aJns/verkotetut-sulat/README.md

# verkotetut-sulat
ELT-23100 Verkotetut sulautetut järjestelmät kurssin harkkatyö
