aJns/verkotetut-sulat/selostus/tyoselostus.tex

\documentclass{article}

\usepackage{graphicx}
\usepackage{amsmath}
\usepackage[utf8]{inputenc}
\usepackage[a4paper]{geometry}
\usepackage{fullpage}
\usepackage[default]{lato}
\usepackage[ddmmyyyy]{datetime}
\usepackage[style=ieee]{biblatex}
\usepackage{url}
\usepackage[finnish]{babel}
\usepackage{hyperref}
\usepackage{float}
\usepackage{listings}
\usepackage{textcomp}

\graphicspath{{./kuvat/}}
\bibliography{tyoselostus}

%----------------------------------------------------------------------------------------
%	DOCUMENT INFORMATION
%----------------------------------------------------------------------------------------

\title{IoT Ledivilkutin \\ ELT-23100 Verkotetut sulautetut järjestelmät \\ Työselostus} % Title

\author{Jonas Nikula \\ Opnro 240497} % Author name

\date{\today} % Date for the report

\begin{document}

\maketitle % Insert the title, author and date

%----------------------------------------------------------------------------------------
%	CONTENT
%----------------------------------------------------------------------------------------

\input{sisalto}

%----------------------------------------------------------------------------------------
%	BIBLIOGRAPHY
%----------------------------------------------------------------------------------------

% \DefineBibliographyStrings{finnish}
\printbibliography{}

%----------------------------------------------------------------------------------------

\end{document}
