aJns/verkotetut-sulat/kicad/verkotetut-sulat.kicad_pcb

## KiCad design kicad/verkotetut-sulat.kicad_pcb (2016-11-24)

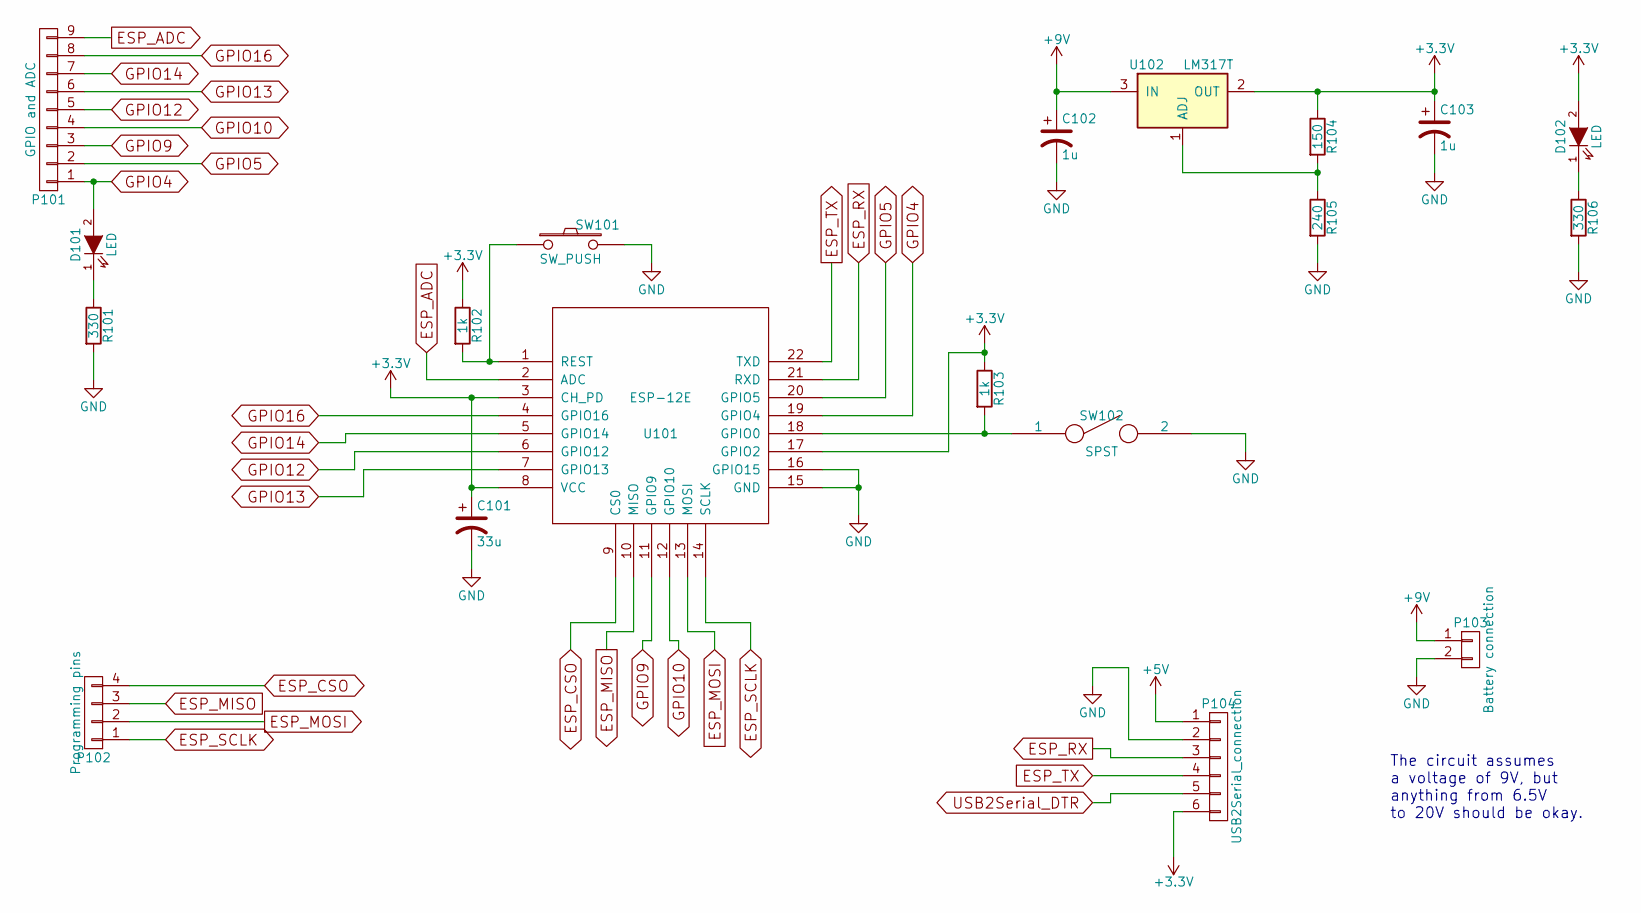
[picture p2: schematic verkotetut-sulat.sch]

Parts:
C101: 33u; C_Radial_D10_L21_P5
C102, C103: 1u; C_Radial_D5_L11_P2
D101, D102: LED; LED_0603
P101: GPIO and ADC; Pin_Header_Straight_1x09
P102: Programming pins; Pin_Header_Straight_1x04
P103: Battery connection; Pin_Header_Straight_1x02
P104: USB2Serial_connection; Pin_Header_Straight_1x06
R101, R106: 330; R_0603
R102, R103: 1k; R_0603
R104: 150; R_0805
R105: 240; R_0805
SW101: SW_PUSH; SW_SPST_B3S-1000
SW102: SPST; SPDT_SMD_SIDE
U101: ESP-12E
U102: LM317T; TO-220_Neutral123_Horizontal

Connections:
+3V3: C101.1, C103.1, D102.2 (A), P104.6, R102.1, R103.1, R104.1, U101.3 (CH_PD), U101.8 (VCC), U101.17 (GPIO2), U102.2 (OUT)
+5V: P104.1
+9V: C102.1, P103.1, U102.3 (IN)
ESP_ADC: P101.9, U101.2 (ADC)
ESP_CSO: P102.4, U101.9 (CS0)
ESP_MISO: P102.3, U101.10 (MISO)
ESP_MOSI: P102.2, U101.13 (MOSI)
ESP_RX: P104.3, U101.21 (RXD)
ESP_SCLK: P102.1, U101.14 (SCLK)
ESP_TX: P104.4, U101.22 (TXD)
GND: C101.2, C102.2, C103.2, P103.2, P104.2, R101.2, R105.2, R106.2, SW101.2, SW102.2, U101.15 (GND), U101.16 (GPIO15)
GPIO4: D101.2 (A), P101.1, U101.19 (GPIO4)
GPIO5: P101.2, U101.20 (GPIO5)
GPIO9: P101.3, U101.11 (GPIO9)
GPIO10: P101.4, U101.12 (GPIO10)
GPIO12: P101.5, U101.6 (GPIO12)
GPIO13: P101.6, U101.7 (GPIO13)
GPIO14: P101.7, U101.5 (GPIO14)
GPIO16: P101.8, U101.4 (GPIO16)
unnamed: D101.1 (K), R101.1
unnamed: D102.1 (K), R106.1
unnamed: R102.2, SW101.1, U101.1 (REST)
unnamed: R103.2, SW102.1, U101.18 (GPIO0)
unnamed: R104.2, R105.1, U102.1 (ADJ)
USB2Serial_DTR: P104.5

Notes on the sheet:
The circuit assumes a voltage of 9V, but anything from 6.5V to 20V should be okay.

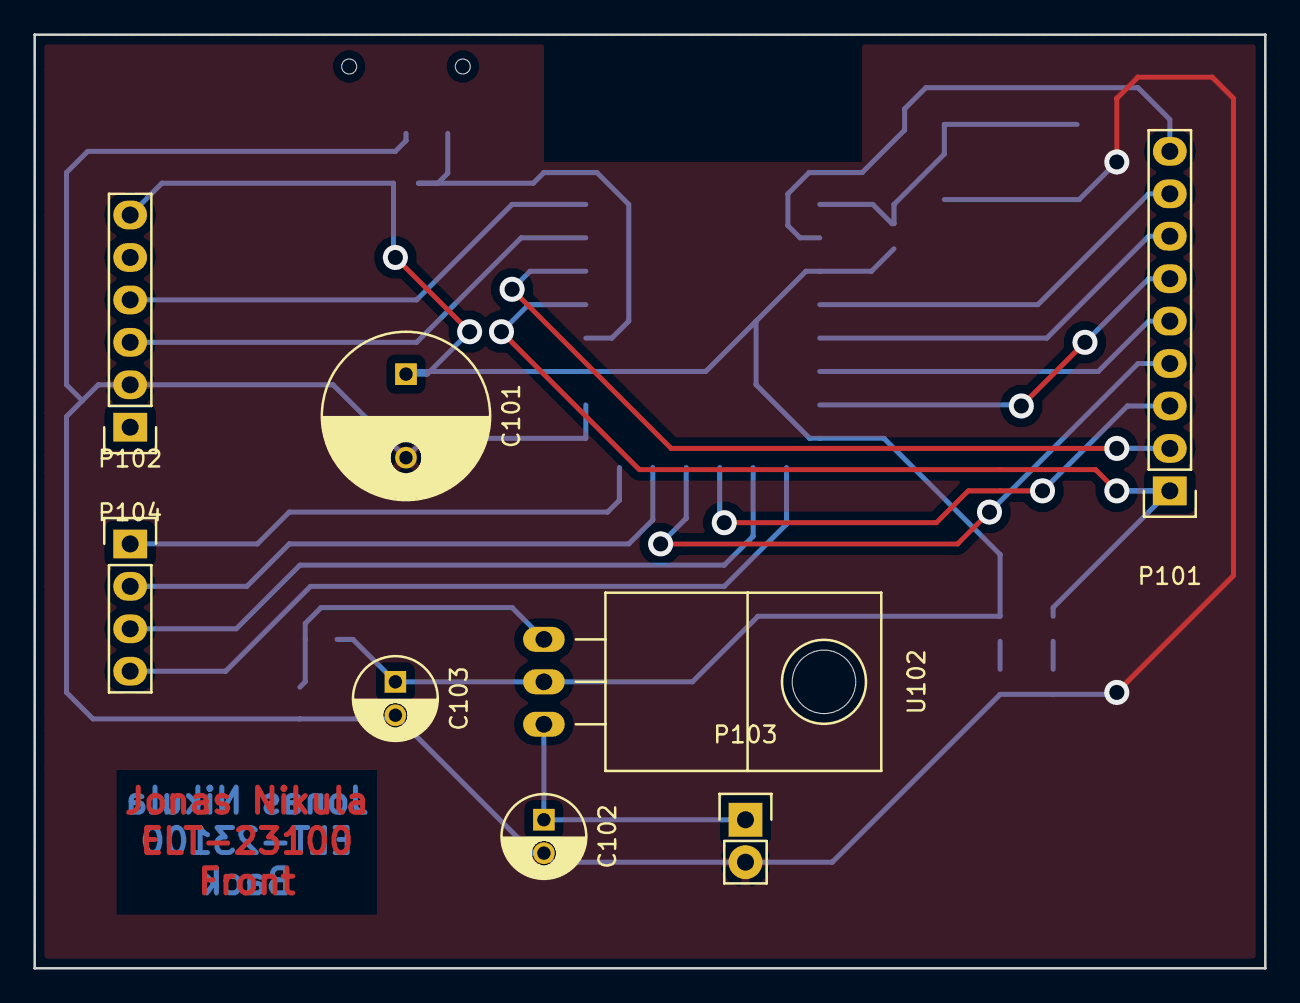
[picture p3: board verkotetut-sulat.kicad_pcb from above]

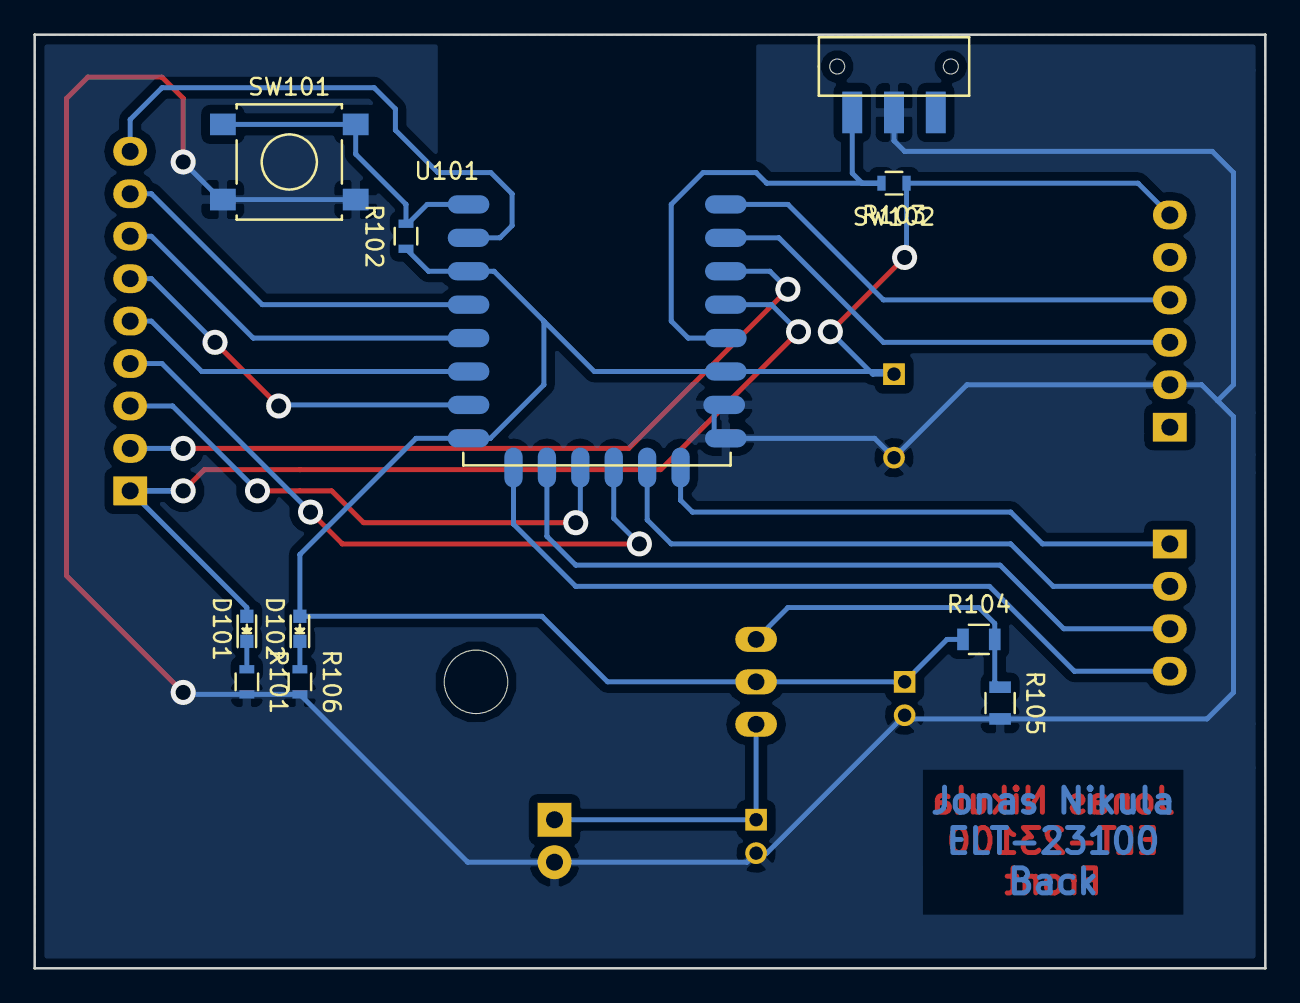
[picture p4: board verkotetut-sulat.kicad_pcb from below]

Board: 2 copper layers, 73.7 x 55.9 mm, 19 parts (11 on the bottom side), 23 nets.
