aJns/verkotetut-sulat/(commit log)

2016-11-15 Make the initial connections in the schematic
    [verkotetut-sulat.sch]
2016-11-15 Finish schematic
    [verkotetut-sulat.sch]
2016-11-15 Add a LED to GPIO4 and a pinout for ADC
    [verkotetut-sulat.sch]
2016-11-15 Create netlist
    [verkotetut-sulat.sch]
2016-11-16 Start PCB design
    [verkotetut-sulat.kicad_pcb, verkotetut-sulat.sch]
2016-11-16 Work on pcb
    [verkotetut-sulat.kicad_pcb]
2016-11-23 Draw all connections
    [verkotetut-sulat.kicad_pcb]
2016-11-24 Pour copper
    [verkotetut-sulat.kicad_pcb]
2016-11-24 Increase via size
    [verkotetut-sulat.kicad_pcb]
2016-11-24 Add text to board
    [verkotetut-sulat.kicad_pcb]
2016-11-24 Export masks
    [verkotetut-sulat.kicad_pcb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]
2016-12-08 Read led_state from website
2016-12-08 Light led according to web site state
2016-12-12 Add POST to change led_state on button press
2016-12-23 Add pictures of the finished PCB
